Krnroyy/FPGA-AES128-CTR-Image-Encryption/results/ctr_dma_run1/raw/benchmark_runs.csv

run | kind | source | counter_hex | input_sha256 | ciphertext_sha256 | recovered_sha256 | exact_recovery | encryption_time_us | encryption_throughput_kbps | decryption_time_us | decryption_throughput_kbps | original_entropy_all | original_entropy_r | original_entropy_g | original_entropy_b | original_corr_horizontal | original_corr_vertical | original_corr_diagonal | original_histogram_chi_square | encrypted_entropy_all | encrypted_entropy_r | encrypted_entropy_g | encrypted_entropy_b | encrypted_corr_horizontal | encrypted_corr_vertical | encrypted_corr_diagonal | encrypted_histogram_chi_square
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
