Krnroyy/FPGA-AES128-CTR-Image-Encryption/results/image/input_image.jpg

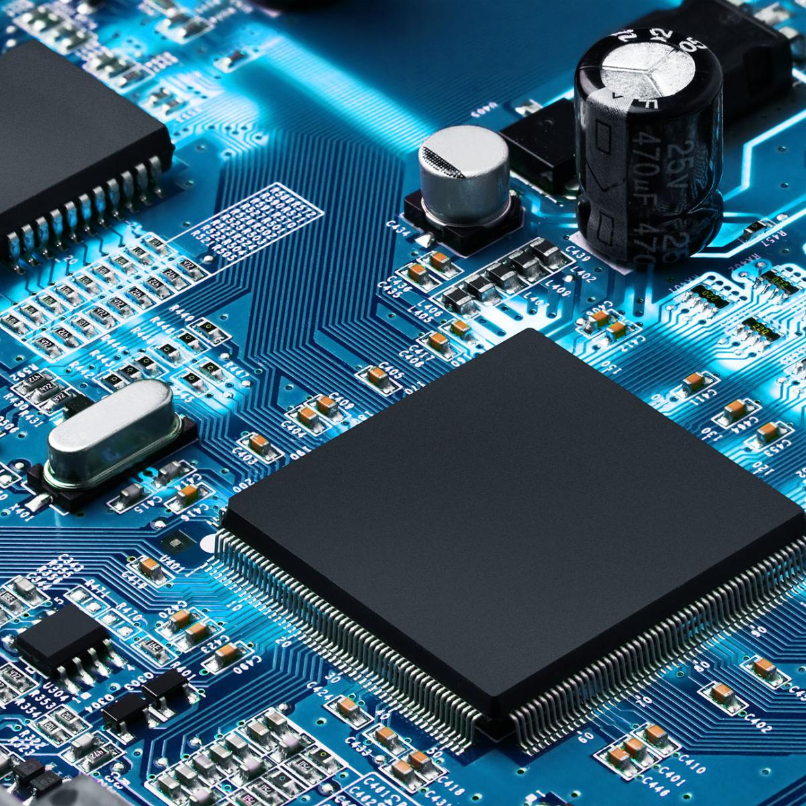
results/image/input_image.jpg
