Krnroyy/FPGA-AES128-CTR-Image-Encryption/(commit log)

2026-09-05 Add verified ZCU104 AES-128 CTR image pipeline
    Integrate AXI4-Lite AES accelerator, Cortex-A53 application, UART receiver, implementation reports, security analysis, and reproducible Vivado build files.
2026-09-06 Add verified AES-GCM DMA authenticated image pipeline
    [benchmark_runs.csv, ctr_vs_gcm.csv, gcm_benchmark_runs.csv]
2026-09-06 Delete docsARTIX7_BASELINE.md duplicate file
    current file present in doc/
2026-09-06 Add missing GCM Vitis application sources
    [platform.h]
2026-10-19 Add PCF security research sources, board evidence, and cancellation candidate
